MarkusFischer/ir-train-detector/board/ir-train-detector.kicad_pcb

## KiCad design board/ir-train-detector.kicad_pcb (2023-03-22)

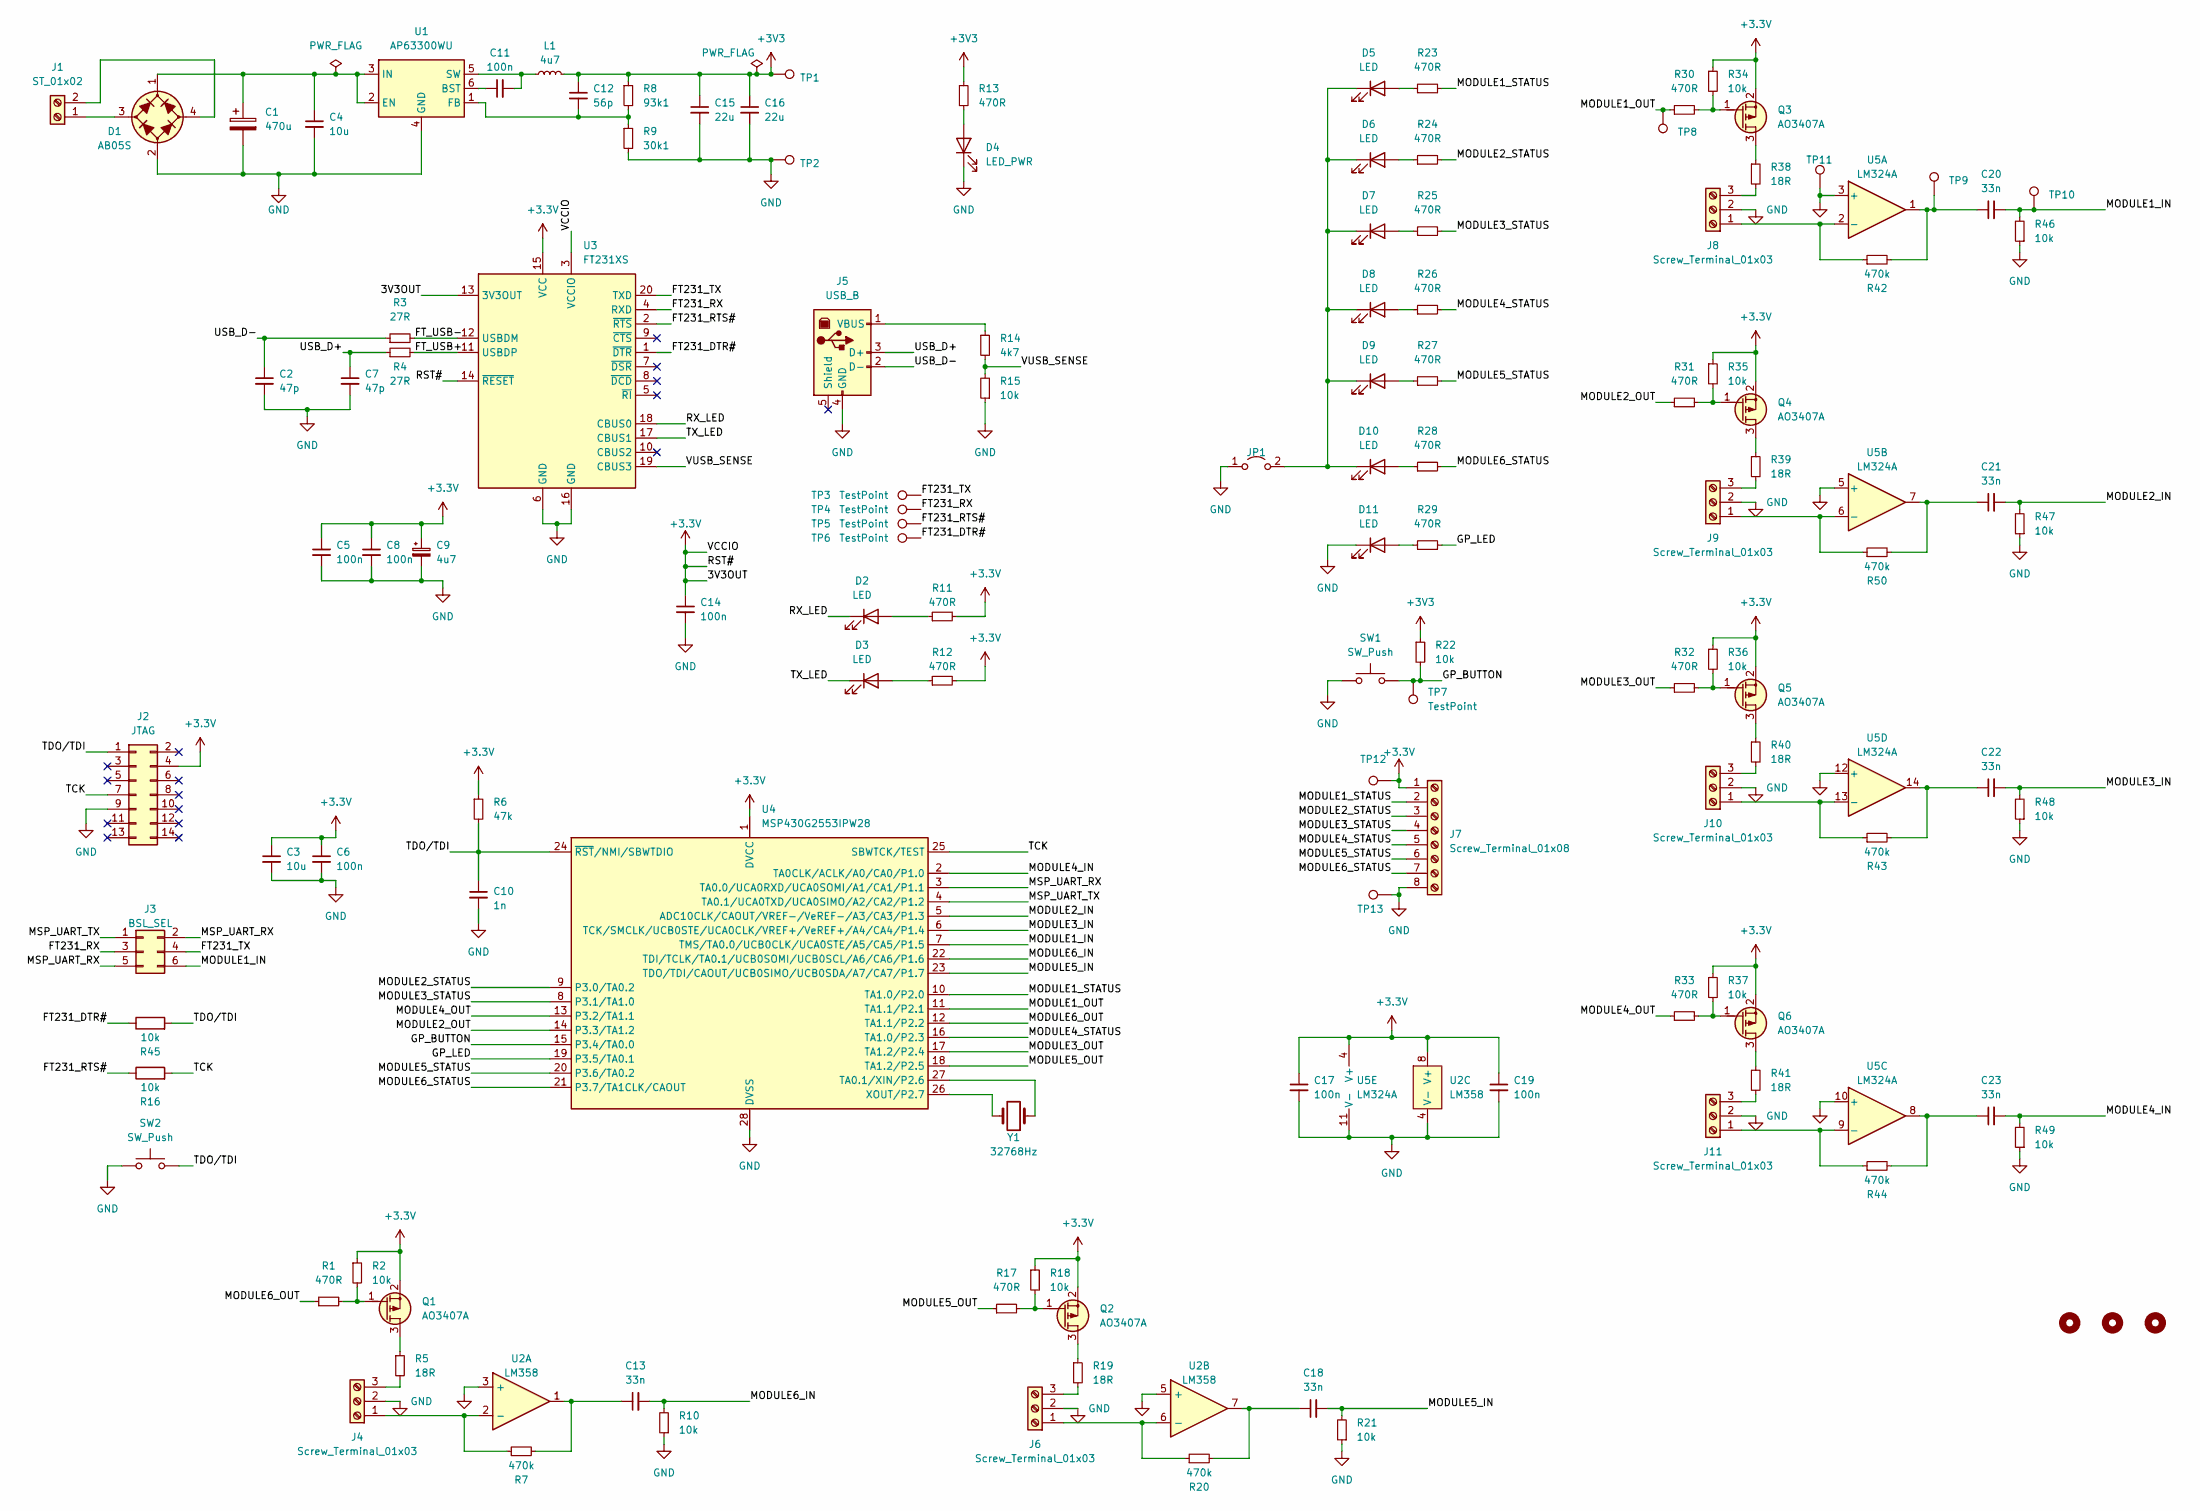
[picture p1: schematic ir-train-detector.kicad_sch, Infrared model train detector]

Parts:
C1: 470u; CP_Radial_D10.0mm_P5.00mm
C2, C7: 47p; C_0805_2012Metric
C3, C4: 10u; C_1206_3216Metric
C5, C6, C8, C11, C14, C17, C19: 100n; C_0603_1608Metric
C9: 4u7; CP_Radial_D4.0mm_P1.50mm
C10: 1n; C_0805_2012Metric
C12: 56p; C_0805_2012Metric
C13, C18, C20, C21, C22, C23: 33n; C_0603_1608Metric
C15, C16: 22u; C_1206_3216Metric
D1: AB05S; Diode_Bridge_Diotec_ABS
D2, D3, D5, D6, D7, D8, D9, D10, D11: LED; LED_0603_1608Metric_Pad1.05x0.95mm_HandSolder
D4: LED_PWR; LED_0603_1608Metric_Pad1.05x0.95mm_HandSolder
H1, H2, H3: MountingHole; MountingHole_3.2mm_M3_DIN965
J1: ST_01x02; TerminalBlock_RND_205-00001_1x02_P5.00mm_Horizontal
J2: JTAG; IDC-Header_2x07_P2.54mm_Vertical
J3: BSL_SEL; PinHeader_2x03_P2.54mm_Vertical
J4, J6, J8, J9, J10, J11: Screw_Terminal_01x03; TerminalBlock_RND_205-00013_1x03_P5.00mm_Horizontal
J5: USB_B; USB_B_Lumberg_2411_02_Horizontal
J7: Screw_Terminal_01x08; TerminalBlock_RND_205-00007_1x08_P5.00mm_Horizontal
JP1: Jumper_2_Open; JUMPER_SMD_1x2
L1: 4u7; L_Radial_D7.0mm_P3.00mm
Q1, Q2, Q3, Q4, Q5, Q6: AO3407A; SOT-23
R1, R11, R12, R13, R17, R23, R24, R25, R26, R27, R28, R29, R30, R31, R32, R33: 470R; R_0603_1608Metric_Pad1.05x0.95mm_HandSolder
R2, R10, R15, R16, R18, R21, R22, R34, R35, R36, R37, R45, R46, R47, R48, R49: 10k; R_0603_1608Metric_Pad1.05x0.95mm_HandSolder
R3, R4: 27R; R_0603_1608Metric_Pad1.05x0.95mm_HandSolder
R5, R19, R38, R39, R40, R41: 18R; R_1206_3216Metric_Pad1.42x1.75mm_HandSolder
R6: 47k; R_0603_1608Metric_Pad1.05x0.95mm_HandSolder
R7, R20, R42, R43, R44, R50: 470k; R_0603_1608Metric_Pad1.05x0.95mm_HandSolder
R8: 93k1; R_1206_3216Metric_Pad1.42x1.75mm_HandSolder
R9: 30k1; R_1206_3216Metric_Pad1.42x1.75mm_HandSolder
R14: 4k7; R_0603_1608Metric_Pad1.05x0.95mm_HandSolder
SW1, SW2: SW_Push; SW_PUSH_6mm
TP1, TP2, TP3, TP4, TP5, TP6, TP7, TP8, TP9, TP10, TP12, TP13: TestPoint; TestPoint_Pad_D1.5mm
TP11: TestPoint; TestPoint_Pad_1.5x1.5mm
U1: AP63300WU; TSOT-23-6_HandSoldering
U2: LM358; SOIC-8_3.9x4.9mm_P1.27mm; JLCPCB ID C7951
U3: FT231XS; SSOP-20_3.9x8.7mm_P0.635mm
U4: MSP430G2553IPW28; TSSOP-28_4.4x9.7mm_P0.65mm
U5: LM324A; SOIC-14_3.9x8.7mm_P1.27mm
Y1: 32768Hz; Crystal_C26-LF_D2.1mm_L6.5mm_Horizontal

Connections:
/FT231_DTR#: R45.1, TP6.1, U3.1 (~DTR)
/FT231_RTS#: R16.1, TP5.1, U3.2 (~RTS)
/FT231_RX: J3.3, TP4.1, U3.4 (RXD)
/FT231_TX: J3.4, TP3.1, U3.20 (TXD)
/FT_USB+: R4.2, U3.11 (USBDP)
/FT_USB-: R3.2, U3.12 (USBDM)
/GP_BUTTON: R22.2, SW1.2, TP7.1, U4.15 (P3.4/TA0.0)
/GP_LED: R29.2, U4.19 (P3.5/TA0.1)
/MODULE1_IN: C20.2, J3.6, R46.2, TP10.1, U4.7 (TMS/TA0.0/UCB0CLK/UCA0STE/A5/CA5/P1.5)
/MODULE1_OUT: R30.1, TP8.1, U4.11 (TA1.1/P2.1)
/MODULE1_STATUS: J7.2, R23.2, U4.10 (TA1.0/P2.0)
/MODULE2_IN: C21.2, R47.2, U4.5 (ADC10CLK/CAOUT/VREF-/VeREF-/A3/CA3/P1.3)
/MODULE2_OUT: R31.1, U4.14 (P3.3/TA1.2)
/MODULE2_STATUS: J7.3, R24.2, U4.9 (P3.0/TA0.2)
/MODULE3_IN: C22.2, R48.2, U4.6 (TCK/SMCLK/UCB0STE/UCA0CLK/VREF+/VeREF+/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)
/MODULE3_OUT: R32.1, U4.17 (TA1.2/P2.4)
/MODULE3_STATUS: J7.4, R25.2, U4.8 (P3.1/TA1.0)
/MODULE4_IN: C23.2, R49.2, U4.2 (TA0CLK/ACLK/A0/CA0/P1.0)
/MODULE4_OUT: R33.1, U4.13 (P3.2/TA1.1)
/MODULE4_STATUS: J7.5, R26.2, U4.16 (TA1.0/P2.3)
/MODULE5_IN: C18.2, R21.2, U4.23 (TDO/TDI/CAOUT/UCB0SIMO/UCB0SDA/A7/CA7/P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)
/MODULE5_OUT: R17.1, U4.18 (TA1.2/P2.5)
/MODULE5_STATUS: J7.6, R27.2, U4.20 (P3.6/TA0.2)
/MODULE6_IN: C13.2, R10.2, U4.22 (TDI/TCLK/TA0.1/UCB0SOMI/UCB0SCL/A6/CA6/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)
/MODULE6_OUT: R1.1, U4.12 (TA1.1/P2.2)
/MODULE6_STATUS: J7.7, R28.2, U4.21 (P3.7/TA1CLK/CAOUT)
/MSP_UART_RX: J3.2, J3.5, U4.3 (TA0.0/UCA0RXD/UCA0SOMI/A1/CA1/P1.1)
/MSP_UART_TX: J3.1, U4.4 (TA0.1/UCA0TXD/UCA0SIMO/A2/CA2/P1.2)
/RX_LED: D2.1 (K), U3.18 (CBUS0)
/TCK: J2.7, R16.2, U4.25 (SBWTCK/TEST)
/TDO/TDI: C10.1, J2.1, R6.2, R45.2, SW2.2, U4.24 (~RST/NMI/SBWTDIO)
/TX_LED: D3.1 (K), U3.17 (CBUS1)
/USB_D+: C7.1, J5.3 (D+), R4.1
/USB_D-: C2.1, J5.2 (D-), R3.1
/VUSB_SENSE: R14.2, R15.2, U3.19 (CBUS3)
GND: C1.2, C2.2, C3.2, C4.2, C5.2, C6.2, C7.2, C8.2, C9.2, C10.2, C14.2, C15.2, C16.2, C17.2, C19.2, D1.2 (-), D4.1 (K), D11.1 (K), J2.9, J4.2, J5.4 (GND), J6.2, J7.8, J8.2, J9.2, J10.2, J11.2, JP1.1 (A), R9.2, R10.1, R15.1, R21.1, R46.1, R47.1, R48.1, R49.1, SW1.1, SW2.1, TP2.1, TP11.1, TP13.1, U1.4 (GND), U2.3 (+), U2.4 (V-), U2.5 (+), U3.6 (GND), U3.16 (GND), U4.28 (DVSS), U5.3 (+), U5.5 (+), U5.10 (+), U5.11 (V-), U5.12 (+); also elsewhere on the board
unnamed: C1.1, C4.1, D1.1 (+), U1.2 (EN), U1.3 (IN)
unnamed: C13.1, R7.2, U2.1
unnamed: C18.1, R20.2, U2.7
unnamed: C20.1, R42.2, TP9.1, U5.1
unnamed: C21.1, R50.2, U5.7
unnamed: C22.1, R43.2, U5.14
unnamed: C23.1, R44.2, U5.8
unnamed: D1.3 (1), J1.1
unnamed: D1.4 (2), J1.2
unnamed: D2.2 (A), R11.1
unnamed: D3.2 (A), R12.1
unnamed: D4.2 (A), R13.2
unnamed: D5.2 (A), R23.1
unnamed: D6.2 (A), R24.1
unnamed: D7.2 (A), R25.1
unnamed: D8.2 (A), R26.1
unnamed: D9.2 (A), R27.1
unnamed: D10.2 (A), R28.1
unnamed: D5.1 (K), D6.1 (K), D7.1 (K), D8.1 (K), D9.1 (K), D10.1 (K), JP1.2 (B)
unnamed: D11.2 (A), R29.1
unnamed: J4.1, R7.1, U2.2 (-)
unnamed: J4.3, R5.2
unnamed: J5.1 (VBUS), R14.1
unnamed: J6.1, R20.1, U2.6 (-)
unnamed: J6.3, R19.2
unnamed: J8.1, R42.1, U5.2 (-)
unnamed: J8.3, R38.2
unnamed: J9.1, R50.1, U5.6 (-)
unnamed: J9.3, R39.2
unnamed: J10.1, R43.1, U5.13 (-)
unnamed: J10.3, R40.2
unnamed: J11.1, R44.1, U5.9 (-)
unnamed: J11.3, R41.2
unnamed: Q1.3 (D), R5.1
unnamed: Q1.1 (G), R1.2, R2.2
unnamed: Q2.3 (D), R19.1
unnamed: Q2.1 (G), R17.2, R18.2
unnamed: Q3.3 (D), R38.1
unnamed: Q3.1 (G), R30.2, R34.2
unnamed: Q4.3 (D), R39.1
unnamed: Q4.1 (G), R31.2, R35.2
unnamed: Q5.3 (D), R40.1
unnamed: Q5.1 (G), R32.2, R36.2
unnamed: Q6.3 (D), R41.1
unnamed: Q6.1 (G), R33.2, R37.2
unnamed: C11.1, U1.6 (BST)
unnamed: C12.2, R8.2, R9.1, U1.1 (FB)
unnamed: C11.2, L1.1, U1.5 (SW)
unnamed: U4.27 (TA0.1/XIN/P2.6), Y1.1
unnamed: U4.26 (XOUT/P2.7), Y1.2

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
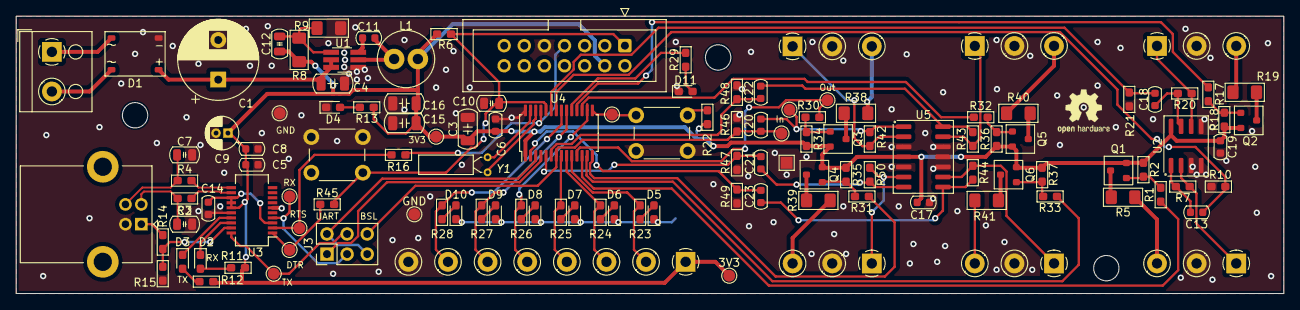
[picture p2: board ir-train-detector.kicad_pcb from above]

Board: 2 copper layers, 160.0 x 35.0 mm, 127 parts (1 on the bottom side), 87 nets.

Other parts of the board:
3V3: TestPoint; TestPoint_Pad_D1.5mm
GND: TestPoint; TestPoint_Pad_D1.5mm

Their connections:
GND: GND.1; also elsewhere on the board
