MarkusFischer/ir-train-detector/firmware/constants.h

#ifndef IR_TRAIN_DETECTOR_CONSTANTS_H
#define IR_TRAIN_DETECTOR_CONSTANTS_H

#include <cstdint>

extern const std::uint16_t comparator_count_value __attribute__((location(0x1042), retain));


#endif //IR_TRAIN_DETECTOR_CONSTANTS_H
