MarkusFischer/ir-train-detector/(commit log)

2022-12-29 starting to design hardware
    [ir-train-detector.kicad_pcb, ir-train-detector.kicad_sch]
2023-01-18 power section schematic finished
    [ir-train-detector.kicad_sch]
2023-01-21 added usb interface
    [ir-train-detector.kicad_sch]
2023-01-22 first draft of final schematic
    [ir-train-detector.kicad_sch]
2023-01-22 pdf schematic
2023-01-24 added footprints
    [ir-train-detector.kicad_sch]
2023-01-25 finished schematic
    [ir-train-detector.kicad_pcb, ir-train-detector.kicad_sch]
2023-01-26 board layout
    [ir-train-detector.kicad_pcb, ir-train-detector.kicad_sch]
2023-01-26 finished board
    [ir-train-detector.kicad_pcb]
2023-01-27 finished hardware revision 1.0
    [ir-train-detector.kicad_pcb, ir-train-detector.kicad_sch]
2023-02-06 production hw rev 1.0
    [ir-train-detector.kicad_pcb]
2023-03-22 finished hardware rev 1.1
    [ir-train-detector.kicad_pcb, ir-train-detector.kicad_sch]
2023-05-09 statuse led manager to allow multiple channels
2023-05-10 rough usage of uart
2023-06-25 uart interrupts working; design of commands
2023-09-10 rework of uart commands
2023-09-10 updated uart command set
2023-09-10 use fixed sized status manager
    [StatusManager.cpp, StatusManager.h, UartHandler.h, main.cpp]
2023-09-10 first implementation of uart commands
2023-09-16 ring buffered queue for uart
2023-09-16 std::lock_guard like wrapper to disable (and reenable) interrupts
2023-09-16 fixed uart errors
2023-09-20 Multi channel implementation with fixed gate time
    [StatusManager.cpp, StatusManager.h, constants.cpp, constants.h, flags.h, interrupts.cpp, interrupts.h, main.cpp]
2023-09-21 fixed multi channel mode
    [main.cpp]
2023-09-22 try to fix faulty uart
    [StatusManager.cpp, StatusManager.h, UartHandler.h, constants.cpp, interrupts.cpp, interrupts.h, main.cpp]
2023-09-23 using low power modes
